bozotics/sensor/sensorlog/2020-05-15-SensorLog5.md

# 15 May

- so KICAD allows for symbols to either be matched to a footprint or to use a
  generic footprint, hmmmmmm

- nevermind, 0.2 ohm we have can't work since the power rating is too low, going
  to use a 0.22 ohm 1210 1/3W instead
