bozotics/sensor/Multimeter.brd

## EAGLE design Multimeter.brd (2020-06-14)

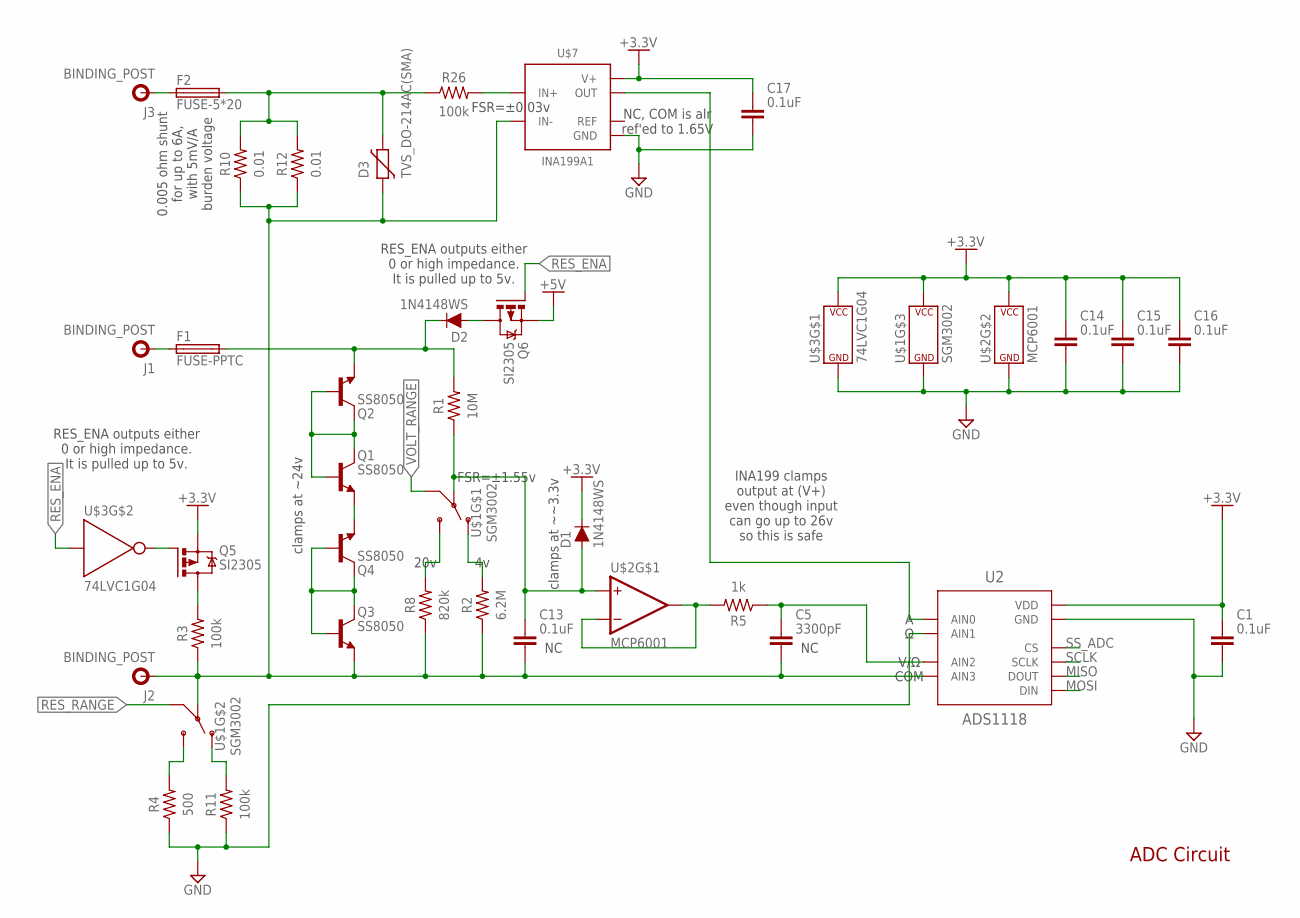
[picture p4: schematic Multimeter.sch, sheet 1, ADC]

Parts:
C1, C13, C14, C15, C16, C17: 0.1uF; CAPC1608X85
C5: 3300pF; CAPC1608X85
D1, D2: 1N4148WS; SOD-323
D3: TVS_DO-214AC(SMA); DIOM5226X290N
F1: FUSE-PPTC; FUSE-PPTC-TH
F2: FUSE-5*20; FUSEHOLDER_"HD"
J1, J2, J3: BINDING_POST
Q1, Q2, Q3, Q4: SS8050; SOT95P237X112-3N
Q5, Q6: SI2305; SOT23
R1: 10M; RESC1608X60
R2: 6.2M; RESC1608X60
R3, R11, R26: 100k; RESC1608X60
R4: 500; RESC1608X60
R5: 1k; RESC1608X60
R8: 820k; RESC1608X60
R10, R12: 0.01; RESC6332X71
U2: ADS1118; VSSOP10
U$1: SGM3002; MSOP10
U$2: MCP6001; SOT23-5
U$3: 74LVC1G04; SOT23-5
U$7: INA199A1; SC70-6

Connections:
+3.3V: C1.1, C14.1, C15.1, C16.1, C17.1, D1.C, Q5.2 (S), U2.8 (VDD), U$1.8 (P$V+), U$2.5 (P$V+), U$3.5 (P$V+), U$7.3 (V+); also elsewhere on the board
+5V: Q6.2 (S); also elsewhere on the board
COM: C5.2, C13.2, D3.1, J2.P$1, Q3.1 (E), R2.1, R3.1, R8.1, R10.1, R12.1, U2.7 (AIN3), U$1.6 (COM), U$7.5 (IN-)
GND: C1.2, C14.2, C15.2, C16.2, C17.2, R4.1, R11.1, U2.3 (GND), U2.5 (AIN1), U$1.3 (P$V-), U$2.2 (P$V-), U$3.3 (P$V-), U$7.2 (GND); also elsewhere on the board
MISO: U2.9 (DOUT); also elsewhere on the board
MOSI: U2.10 (DIN); also elsewhere on the board
unnamed: D2.C, F1.P$2 (2), Q2.1 (E), R1.2
unnamed: C13.1, D1.A, R1.1, U$1.10 (COM), U$2.3 (+IN)
unnamed: D2.A, Q6.3 (D)
unnamed: Q3.2 (B), Q3.3 (C), Q4.2 (B), Q4.3 (C)
unnamed: F2.P$1 (1), J3.P$1
unnamed: R5.2, U$2.1 (OUT), U$2.4 (-IN)
unnamed: C5.1, R5.1, U2.6 (AIN2)
unnamed: U2.4 (AIN0), U$7.6 (OUT)
unnamed: R4.2, U$1.4 (NO)
unnamed: R8.2, U$1.2 (NO)
unnamed: R2.2, U$1.9 (NC)
unnamed: Q1.2 (B), Q1.3 (C), Q2.2 (B), Q2.3 (C)
unnamed: Q1.1 (E), Q4.1 (E)
unnamed: F1.P$1 (1), J1.P$1
unnamed: R11.2, U$1.7 (NC)
unnamed: D3.2, F2.P$2 (2), R10.2, R12.2, R26.1
unnamed: Q5.3 (D), R3.2
unnamed: Q5.1 (G), U$3.4 (Y)
unnamed: R26.2, U$7.4 (IN+)
RES_ENA: Q6.1 (G), U$3.2 (A); also elsewhere on the board
RES_RANGE: U$1.5 (IN); also elsewhere on the board
SCLK: U2.1 (SCLK); also elsewhere on the board
SS_ADC: U2.2 (CS); also elsewhere on the board
VOLT_RANGE: U$1.1 (IN); also elsewhere on the board

Notes on the sheet:
clamps at ~24v
V/Ω
COM
20v
RES_ENA outputs either 0 or high impedance. It is pulled up to 5v.
clamps at ~~3.3v
0.005 ohm shunt for up to 6A, with 5mV/A burden voltage
NC, COM is alr ref'ed to 1.65V
FSR=±1.55v
FSR=±0.03v
INA199 clamps output at (V+) even though input can go up to 26v so this is safe
ADC Circuit

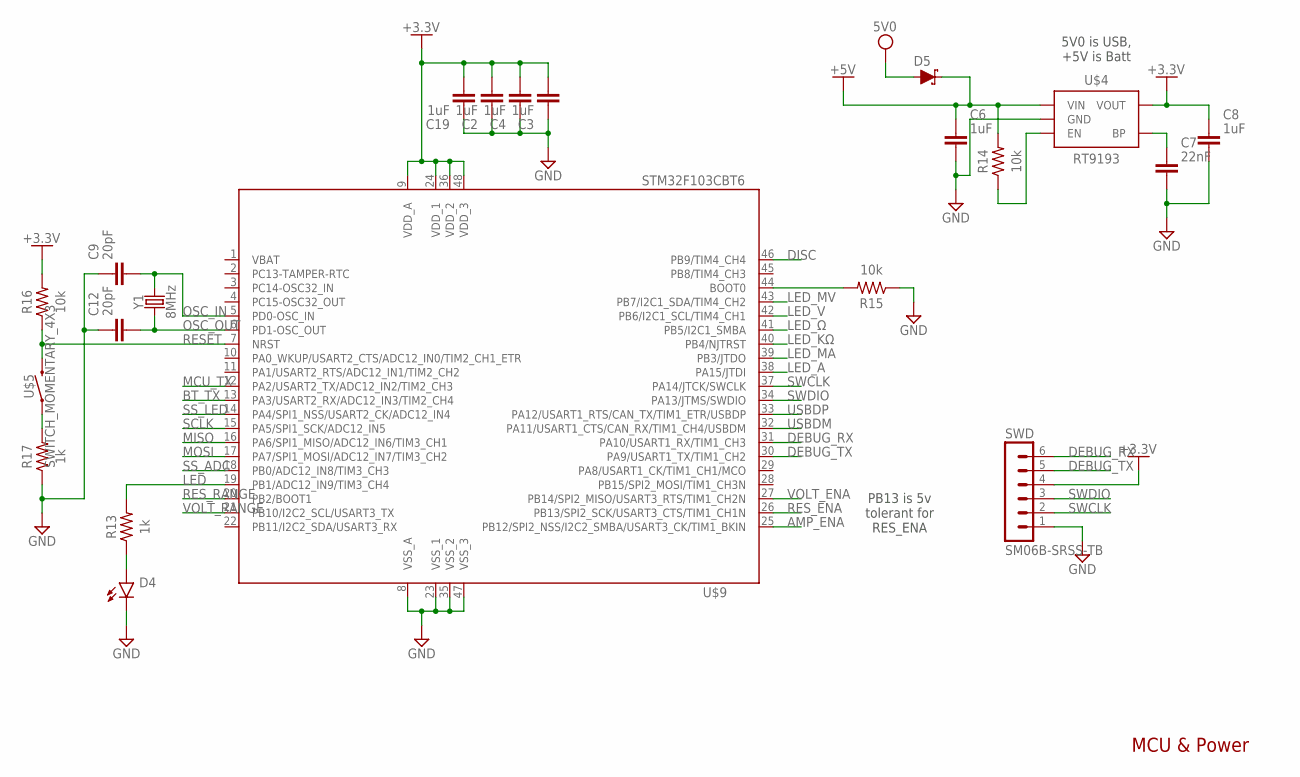
[picture p5: schematic Multimeter.sch, sheet 2, MCU & Power]

Parts:
C2, C3, C4, C6, C8, C19: 1uF; CAPC1608X85
C7: 22nF; CAPC1608X85
C9, C12: 20pF; CAPC1608X85
D4: LED_CHIP_BLUE-1608; LEDC1608X39N_B
D5: DIODE-SCHOTTKY; SMA-DIODE
R13, R17: 1k; RESC1608X60
R14, R15, R16: 10k; RESC1608X60
SWD: SM06B-SRSS-TB
U$4: RT9193; SOT23-5
U$5: SWITCH_MOMENTARY_4X3; MOMENTARY_SWITCH_4X3
U$9: STM32F103CBT6; LQFP48
Y1: 8MHz; CRYSTAL-SMD-5X3.2-2PAD

Connections:
5V0: D5.A; also elsewhere on the board
+3.3V: C2.2, C3.2, C4.2, C8.1, C19.2, R16.2, SWD.4, U$4.5 (VOUT), U$9.9 (VDD_A), U$9.24 (VDD_1), U$9.36 (VDD_2), U$9.48 (VDD_3); also elsewhere on the board
+5V: C6.1, D5.C, R14.2, U$4.1 (VIN); also elsewhere on the board
AMP_ENA: U$9.25 (PB12/SPI2_NSS/I2C2_SMBA/USART3_CK/TIM1_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); also elsewhere on the board
BT_TX: U$9.13 (PA3/USART2_RX/ADC12_IN3/TIM2_CH4); also elsewhere on the board
DEBUG_RX: SWD.6, U$9.31 (PA10/USART1_RX/TIM1_CH3)
DEBUG_TX: SWD.5, U$9.30 (PA9/USART1_TX/TIM1_CH2)
DISC: U$9.46 (PB9/TIM4_CH4); also elsewhere on the board
GND: C2.1, C3.1, C4.1, C6.2, C7.2, C8.2, C9.1, C12.1, C19.1, D4.2 (C), R15.1, R17.1, SWD.1, U$4.2 (GND), U$9.8 (VSS_A), U$9.23 (VSS_1), U$9.35 (VSS_2), U$9.47 (VSS_3); also elsewhere on the board
LED: R13.2, U$9.19 (PB1/ADC12_IN9/TIM3_CH4)
LED_A: U$9.38 (PA15/JTDI); also elsewhere on the board
LED_KΩ: U$9.40 (PB4/NJTRST); also elsewhere on the board
LED_MA: U$9.39 (PB3/JTDO); also elsewhere on the board
LED_MV: U$9.43 (PB7/I2C1_SDA/TIM4_CH2); also elsewhere on the board
LED_V: U$9.42 (PB6/I2C1_SCL/TIM4_CH1); also elsewhere on the board
LED_Ω: U$9.41 (PB5/I2C1_SMBA); also elsewhere on the board
MCU_TX: U$9.12 (PA2/USART2_TX/ADC12_IN2/TIM2_CH3); also elsewhere on the board
MISO: U$9.16 (PA6/SPI1_MISO/ADC12_IN6/TIM3_CH1); also elsewhere on the board
MOSI: U$9.17 (PA7/SPI1_MOSI/ADC12_IN7/TIM3_CH2); also elsewhere on the board
unnamed: D4.1 (A), R13.1
unnamed: R14.1, U$4.3 (EN)
unnamed: C7.1, U$4.4 (BP)
unnamed: R17.2, U$5.P$1 (1)
unnamed: R15.2, U$9.44 (BOOT0)
OSC_IN: C9.2, U$9.5 (PD0-OSC_IN), Y1.P$2 (2)
OSC_OUT: C12.2, U$9.6 (PD1-OSC_OUT), Y1.P$1 (1)
RESET: R16.1, U$5.P$2 (2), U$9.7 (NRST)
RES_ENA: U$9.26 (PB13/SPI2_SCK/USART3_CTS/TIM1_CH1N); also elsewhere on the board
RES_RANGE: U$9.20 (PB2/BOOT1); also elsewhere on the board
SCLK: U$9.15 (PA5/SPI1_SCK/ADC12_IN5); also elsewhere on the board
SS_ADC: U$9.18 (PB0/ADC12_IN8/TIM3_CH3); also elsewhere on the board
SS_LED: U$9.14 (PA4/SPI1_NSS/USART2_CK/ADC12_IN4); also elsewhere on the board
SWCLK: SWD.2, U$9.37 (PA14/JTCK/SWCLK)
SWDIO: SWD.3, U$9.34 (PA13/JTMS/SWDIO)
USBDM: U$9.32 (PA11/USART1_CTS/CAN_RX/TIM1_CH4/USBDM); also elsewhere on the board
USBDP: U$9.33 (PA12/USART1_RTS/CAN_TX/TIM1_ETR/USBDP); also elsewhere on the board
VBAT: U$9.1 (VBAT)
VOLT_ENA: U$9.27 (PB14/SPI2_MISO/USART3_RTS/TIM1_CH2N); also elsewhere on the board
VOLT_RANGE: U$9.21 (PB10/I2C2_SCL/USART3_TX); also elsewhere on the board

Notes on the sheet:
5V0 is USB, +5V is Batt
MCU & Power
PB13 is 5v tolerant for RES_ENA

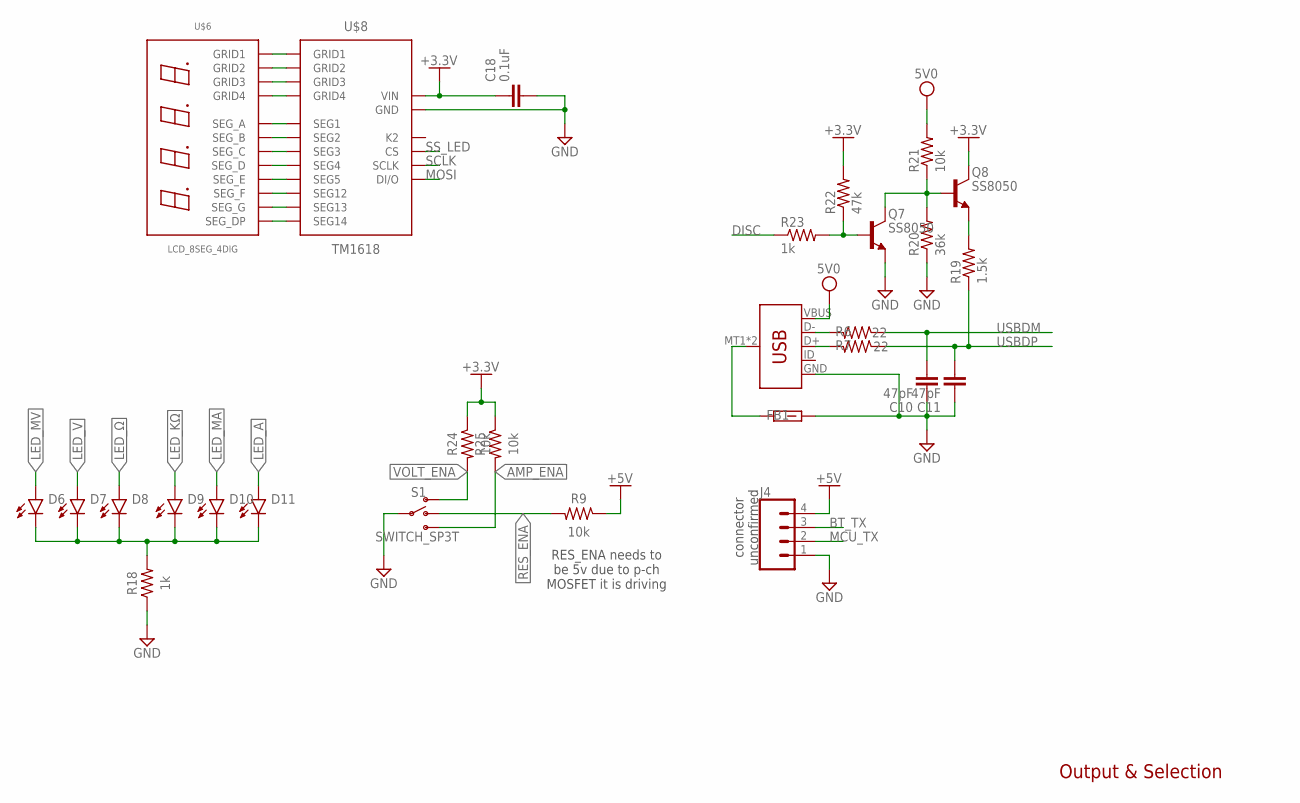
[picture p6: schematic Multimeter.sch, sheet 3, Output & Selection]

Parts:
C10, C11: 47pF; CAPC1608X85
C18: 0.1uF; CAPC1608X85
D6, D7, D8, D9, D10, D11: LED_CHIP_BLUE-1608; LEDC1608X39N_B
FB1: 1k; BEADC1608X95N
J4: CONN_04LOCK; 1X04_LOCK
Q7, Q8: SS8050; SOT95P237X112-3N
R6, R7: 22; RESC1608X60
R9, R21, R24, R25: 10k; RESC1608X60
R18, R23: 1k; RESC1608X60
R19: 1.5k; RESC1608X60
R20: 36k; RESC1608X60
R22: 47k; RESC1608X60
S1: SWITCH_SP3T
U$6: LCD_8SEG_4DIG; LCD_8SEG_4DIG_0.4IN
U$8: TM1618; SOP-18
X1: USB-MINIB; USB-MICROB-CLEANED

Connections:
5V0: R21.2, X1.VBUS; also elsewhere on the board
+3.3V: C18.1, Q8.3 (C), R22.2, R24.1, R25.1, U$8.P5 (VIN); also elsewhere on the board
+5V: J4.4, R9.1; also elsewhere on the board
AMP_ENA: R25.2, S1.4; also elsewhere on the board
BT_TX: J4.3; also elsewhere on the board
DISC: R23.1; also elsewhere on the board
GND: C10.1, C11.1, C18.2, FB1.2, J4.1, Q7.1 (E), R18.1, R20.1, S1.3, U$8.P16 (GND), X1.GND; also elsewhere on the board
LED_A: D11.1 (A); also elsewhere on the board
LED_KΩ: D9.1 (A); also elsewhere on the board
LED_MA: D10.1 (A); also elsewhere on the board
LED_MV: D6.1 (A); also elsewhere on the board
LED_V: D7.1 (A); also elsewhere on the board
LED_Ω: D8.1 (A); also elsewhere on the board
MCU_TX: J4.2; also elsewhere on the board
MOSI: U$8.P1 (DI/O); also elsewhere on the board
unnamed: FB1.1, X1.MT1 (SHIELD), X1.MT2 (SHIELD)
unnamed: U$6.11 (SEG_A), U$8.P6 (SEG1)
unnamed: U$6.7 (SEG_B), U$8.P7 (SEG2)
unnamed: U$6.4 (SEG_C), U$8.P8 (SEG3)
unnamed: U$6.2 (SEG_D), U$8.P9 (SEG4)
unnamed: U$6.1 (SEG_E), U$8.P10 (SEG5)
unnamed: U$6.10 (SEG_F), U$8.P11 (SEG12)
unnamed: U$6.5 (SEG_G), U$8.P12 (SEG13)
unnamed: U$6.3 (SEG_DP), U$8.P13 (SEG14)
unnamed: U$6.6 (GRID4), U$8.P14 (GRID4)
unnamed: U$6.8 (GRID3), U$8.P15 (GRID3)
unnamed: U$6.9 (GRID2), U$8.P17 (GRID2)
unnamed: U$6.12 (GRID1), U$8.P18 (GRID1)
unnamed: D6.2 (C), D7.2 (C), D8.2 (C), D9.2 (C), D10.2 (C), D11.2 (C), R18.2
unnamed: Q8.1 (E), R19.2
unnamed: R6.2, X1.D-
unnamed: R7.2, X1.D+
unnamed: Q7.3 (C), Q8.2 (B), R20.2, R21.1
unnamed: Q7.2 (B), R22.1, R23.2
RES_ENA: R9.2, S1.2; also elsewhere on the board
SCLK: U$8.P2 (SCLK); also elsewhere on the board
SS_LED: U$8.P3 (CS); also elsewhere on the board
USBDM: C10.2, R6.1; also elsewhere on the board
USBDP: C11.2, R7.1, R19.1; also elsewhere on the board
VOLT_ENA: R24.2, S1.1; also elsewhere on the board

Notes on the sheet:
Output & Selection
RES_ENA needs to be 5v due to p-ch MOSFET it is driving
connector unconfirmed

Board: 2 copper layers, 85 parts (0 on the bottom side), 77 nets, no tracks yet.
